theapi/bathroom_scales/datasheets/feather_pinoutbot.jpg

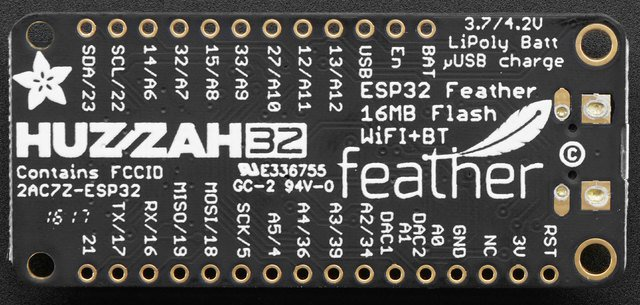
datasheets/feather_pinoutbot.jpg
