theapi/bathroom_scales/README.md

# Bathroom Scales
Hacked bathroom scales to provide data logging

See https://learn.sparkfun.com/tutorials/load-cell-amplifier-hx711-breakout-hookup-guide

Sparkfun repo: https://github.com/sparkfun/HX711-Load-Cell-Amplifier

Library: https://github.com/bogde/HX711
