theapi/bathroom_scales/kicad/stm32L031F4/lcd_reader/project.kicad_pcb

## KiCad design kicad/stm32L031F4/lcd_reader/project.kicad_pcb (2017-12-19)

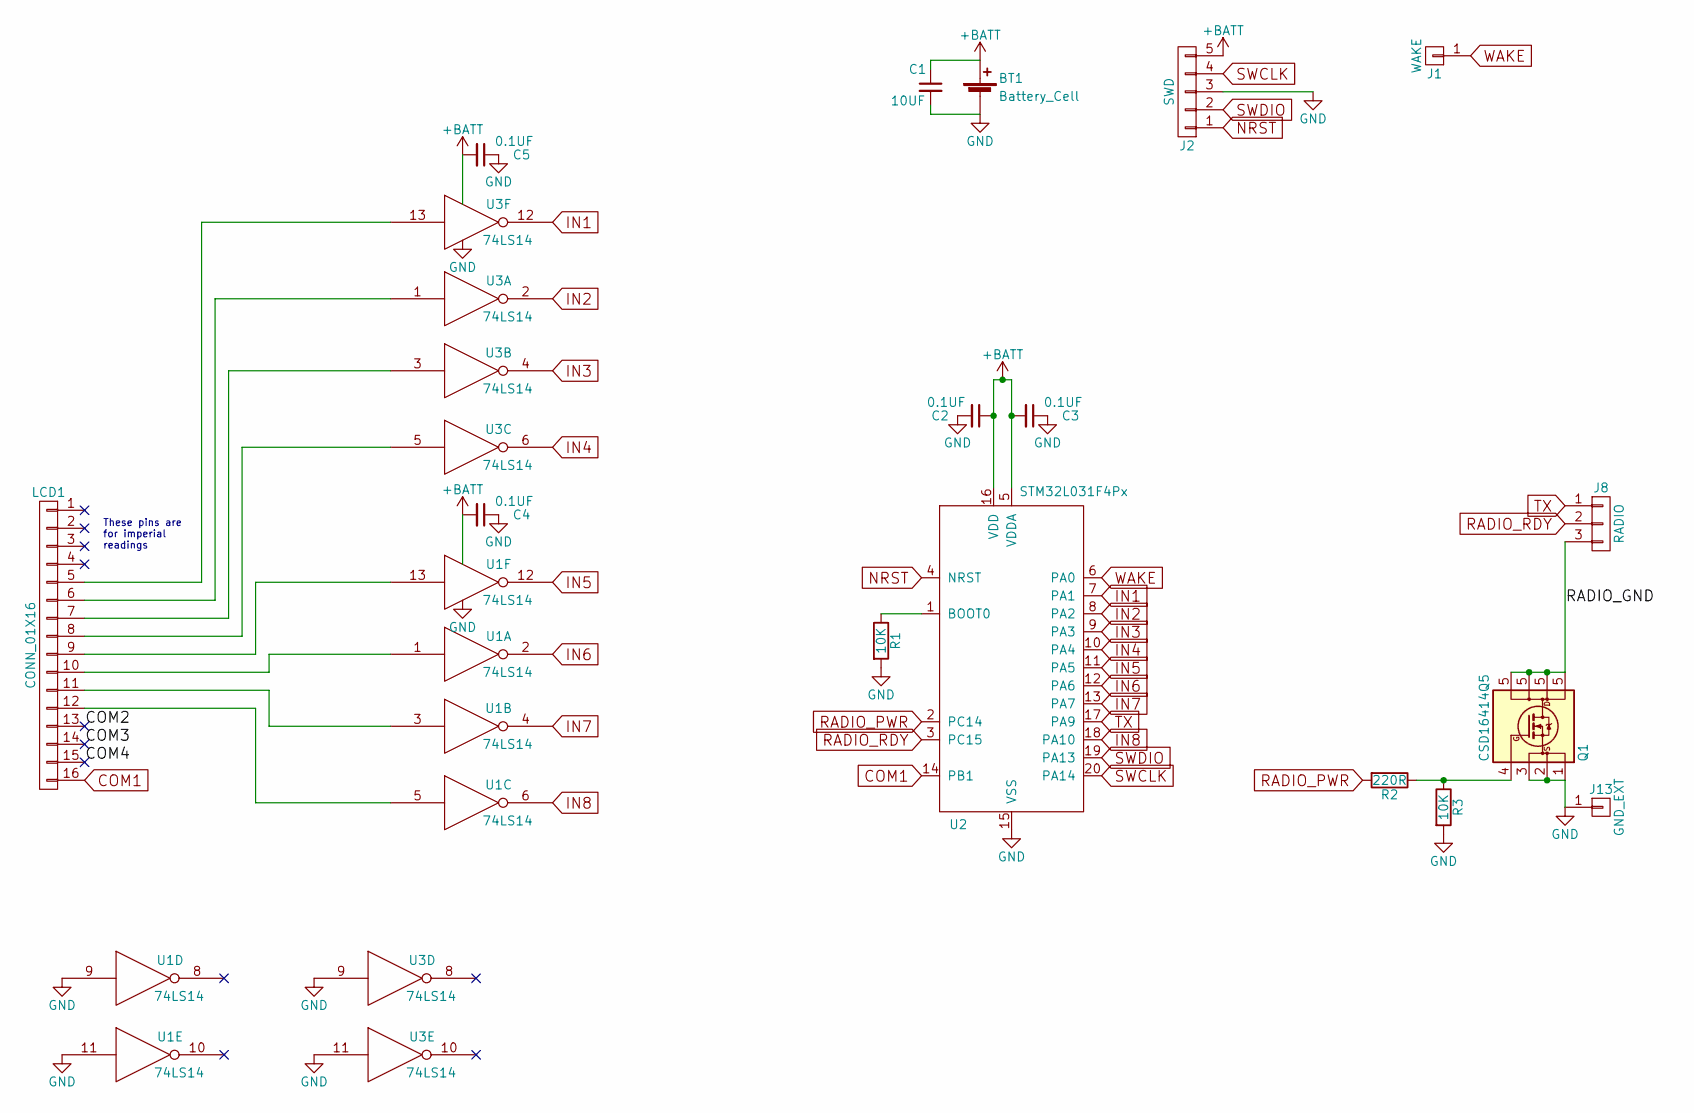
[picture p4: schematic project.sch, LCD Reader]

Parts:
BT1: Battery_Cell; Pin_Header_Straight_2x01_Pitch2.54mm
C1: 10UF; C_0805_HandSoldering
C2, C3, C4, C5: 0.1UF; C_0805_HandSoldering
J1: WAKE; Pin_Header_Straight_1x01_Pitch2.54mm
J2: SWD; Pin_Header_Straight_1x05_Pitch2.54mm
J8: RADIO; Pin_Header_Straight_1x03_Pitch2.54mm
J13: GND_EXT; Pin_Header_Straight_1x01_Pitch2.54mm
LCD1: CONN_01X16; ZEBRA-16
Q1: CSD16414Q5; TDSON-8-1_HandSoldering
R1, R3: 10K; R_0805_HandSoldering
R2: 220R; R_0805_HandSoldering
U1, U3: 74LS14; SOIC-14_3.9x8.7mm_Pitch1.27mm
U2: STM32L031F4Px; TSSOP-20_4.4x6.5mm_Pitch0.65mm

Connections:
+BATT: BT1.1 (+), C1.1, C2.1, C3.2, C4.2, C5.2, J2.5, U1.14 (VCC), U2.5 (VDDA), U2.16 (VDD), U3.14 (VCC)
/COM2: LCD1.13
/COM3: LCD1.14
/COM4: LCD1.15
/RADIO_GND: J8.3, Q1.5 (D)
COM1: LCD1.16, U2.14 (PB1)
GND: BT1.2 (-), C1.2, C2.2, C3.1, C4.1, C5.1, J2.3, J13.1, Q1.1 (S), Q1.2 (S), Q1.3 (S), R1.2, R3.2, U1.7 (GND), U1.9, U1.11, U2.15 (VSS), U3.7 (GND), U3.9, U3.11
IN1: U2.7 (PA1), U3.12
IN2: U2.8 (PA2), U3.2
IN3: U2.9 (PA3), U3.4
IN4: U2.10 (PA4), U3.6
IN5: U1.12, U2.11 (PA5)
IN6: U1.2, U2.12 (PA6)
IN7: U1.4, U2.13 (PA7)
IN8: U1.6, U2.18 (PA10)
NRST: J2.1, U2.4 (NRST)
unnamed: LCD1.5, U3.13
unnamed: LCD1.6, U3.1
unnamed: LCD1.7, U3.3
unnamed: LCD1.8, U3.5
unnamed: LCD1.9, U1.13
unnamed: LCD1.10, U1.1
unnamed: LCD1.11, U1.3
unnamed: LCD1.12, U1.5
unnamed: Q1.4 (G), R2.1, R3.1
unnamed: R1.1, U2.1 (BOOT0)
RADIO_PWR: R2.2, U2.2 (PC14)
RADIO_RDY: J8.2, U2.3 (PC15)
SWCLK: J2.4, U2.20 (PA14)
SWDIO: J2.2, U2.19 (PA13)
TX: J8.1, U2.17 (PA9)
WAKE: J1.1, U2.6 (PA0)

Notes on the sheet:
These pins are for imperial readings

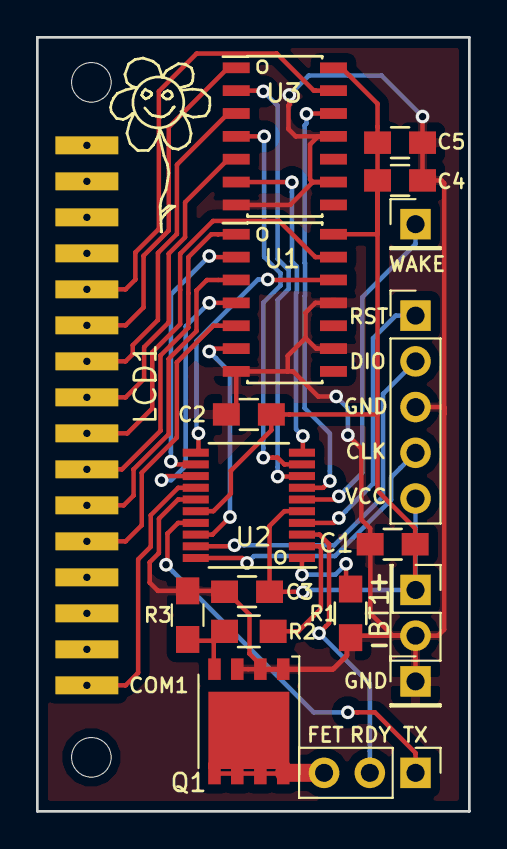
[picture p5: board project.kicad_pcb from above]

Board: 2 copper layers, 24.0 x 43.0 mm, 18 parts (0 on the bottom side), 29 nets.
