theapi/bathroom_scales/stm32L031F4/scales_lcd_read/scales_lcd_read/Src/main.c

/**
  ******************************************************************************
  * File Name          : main.c
  * Description        : Main program body
  ******************************************************************************
  ** This notice applies to any and all portions of this file
  * that are not between comment pairs USER CODE BEGIN and
  * USER CODE END. Other portions of this file, whether 
  * inserted by the user or by software development tools
  * are owned by their respective copyright owners.
  *
  * COPYRIGHT(c) 2017 STMicroelectronics
  *
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
  ******************************************************************************
  */

/* Includes ------------------------------------------------------------------*/
#include "main.h"
#include "stm32l0xx_hal.h"
#include "adc.h"
#include "usart.h"
#include "gpio.h"

/* USER CODE BEGIN Includes */
#include "string.h"
#include "stdlib.h"

#include "lcd.h"
#include "tx.h"
#include "scales.h"

/* USER CODE END Includes */


/* USER CODE BEGIN PV */

/* USER CODE END PV */

void SystemClock_Config(void);

/* USER CODE BEGIN PFP */
void standby();

/* USER CODE END PFP */

/* USER CODE BEGIN 0 */


TXState_TypeDef tx_state = TXSTATE_OFF;

LCD_TypeDef lcd;

/* USER CODE END 0 */

int main(void)
{

  /* MCU Configuration----------------------------------------------------------*/

  /* Reset of all peripherals, Initializes the Flash interface and the Systick. */
  HAL_Init();

  /* Configure the system clock */
  SystemClock_Config();

  /* Initialize all configured peripherals */
  MX_GPIO_Init();
  MX_ADC_Init();
  MX_USART2_UART_Init();

  /* USER CODE BEGIN 2 */

  /* Disable the uart for now */
  HAL_UART_MspDeInit(&huart2);

  /* Check if the system was resumed from Standby mode */
  if (__HAL_PWR_GET_FLAG(PWR_FLAG_SB) != RESET) {
    /* Clear Standby flag */
    __HAL_PWR_CLEAR_FLAG(PWR_FLAG_SB);
  }

  /* Enable Ultra low power mode */
  HAL_PWREx_EnableUltraLowPower();
  //HAL_PWR_EnableWakeUpPin(PWR_WAKEUP_PIN1);

  /* Ensure the transmitter is off */
  HAL_GPIO_WritePin(GPIOC, GPIO_PIN_14, GPIO_PIN_RESET);

  HAL_ADCEx_Calibration_Start(&hadc, ADC_SINGLE_ENDED);
  HAL_ADC_Start(&hadc);

  LCD_int(&lcd);

  /* USER CODE END 2 */

  /* Infinite loop */
  /* USER CODE BEGIN WHILE */
  while (1)
  {
  /* USER CODE END WHILE */

  /* USER CODE BEGIN 3 */

      /* Wait for a weight */
      if (tx_state == TXSTATE_OFF) {
          if (LCD_pollForWeight(&lcd) == 1) {
              tx_state = TXSTATE_SETUP;
          }
      }

      /* Send the weight reading to the transmitter */
      tx_state = TX_StateMachineRun(tx_state, &huart2, &lcd);

      /* Nothing left to do, just power down */
      if (tx_state == TXSTATE_COMPLETE) {
          /* After standby, setup (main) is run again */
          standby();
      }

  }
  /* USER CODE END 3 */

}

/** System Clock Configuration
*/
void SystemClock_Config(void)
{

  RCC_OscInitTypeDef RCC_OscInitStruct;
  RCC_ClkInitTypeDef RCC_ClkInitStruct;
  RCC_PeriphCLKInitTypeDef PeriphClkInit;

    /**Configure the main internal regulator output voltage 
    */
  __HAL_PWR_VOLTAGESCALING_CONFIG(PWR_REGULATOR_VOLTAGE_SCALE3);

    /**Initializes the CPU, AHB and APB busses clocks 
    */
  RCC_OscInitStruct.OscillatorType = RCC_OSCILLATORTYPE_MSI;
  RCC_OscInitStruct.MSIState = RCC_MSI_ON;
  RCC_OscInitStruct.MSICalibrationValue = 0;
  RCC_OscInitStruct.MSIClockRange = RCC_MSIRANGE_4;
  RCC_OscInitStruct.PLL.PLLState = RCC_PLL_NONE;
  if (HAL_RCC_OscConfig(&RCC_OscInitStruct) != HAL_OK)
  {
    _Error_Handler(__FILE__, __LINE__);
  }

    /**Initializes the CPU, AHB and APB busses clocks 
    */
  RCC_ClkInitStruct.ClockType = RCC_CLOCKTYPE_HCLK|RCC_CLOCKTYPE_SYSCLK
                              |RCC_CLOCKTYPE_PCLK1|RCC_CLOCKTYPE_PCLK2;
  RCC_ClkInitStruct.SYSCLKSource = RCC_SYSCLKSOURCE_MSI;
  RCC_ClkInitStruct.AHBCLKDivider = RCC_SYSCLK_DIV1;
  RCC_ClkInitStruct.APB1CLKDivider = RCC_HCLK_DIV1;
  RCC_ClkInitStruct.APB2CLKDivider = RCC_HCLK_DIV1;

  if (HAL_RCC_ClockConfig(&RCC_ClkInitStruct, FLASH_LATENCY_0) != HAL_OK)
  {
    _Error_Handler(__FILE__, __LINE__);
  }

  PeriphClkInit.PeriphClockSelection = RCC_PERIPHCLK_USART2;
  PeriphClkInit.Usart2ClockSelection = RCC_USART2CLKSOURCE_SYSCLK;
  if (HAL_RCCEx_PeriphCLKConfig(&PeriphClkInit) != HAL_OK)
  {
    _Error_Handler(__FILE__, __LINE__);
  }

    /**Configure the Systick interrupt time 
    */
  HAL_SYSTICK_Config(HAL_RCC_GetHCLKFreq()/1000);

    /**Configure the Systick 
    */
  HAL_SYSTICK_CLKSourceConfig(SYSTICK_CLKSOURCE_HCLK);

  /* SysTick_IRQn interrupt configuration */
  HAL_NVIC_SetPriority(SysTick_IRQn, 0, 0);
}

/* USER CODE BEGIN 4 */

void standby() {
  /* The Following Wakeup sequence is highly recommended prior to each Standby mode entry
    mainly when using more than one wakeup source this is to not miss any wakeup event.
     - Disable all used wakeup sources,
     - Clear all related wakeup flags,
     - Re-enable all used wakeup sources,
     - Enter the Standby mode.
  */

  /* Disable all used wakeup sources: PWR_WAKEUP_PIN3 */
  HAL_PWR_DisableWakeUpPin(PWR_WAKEUP_PIN1);

  /* Clear all related wakeup flags*/
  __HAL_PWR_CLEAR_FLAG(PWR_FLAG_WU);

  /* Enable WakeUp Pin PWR_WAKEUP_PIN3 connected to PA.02 (Arduino A7) */
  HAL_PWR_EnableWakeUpPin(PWR_WAKEUP_PIN1);

  /* Enter the Standby mode */
  HAL_PWR_EnterSTANDBYMode();

}

/**
 * Callback for HAL_GPIO_EXTI_IRQHandler()
 * in EXTI0_1_IRQHandler().
 *
 * Handles the external interrupt.
 */
void HAL_GPIO_EXTI_Callback(uint16_t GPIO_Pin) {
    //@todo
}

/* USER CODE END 4 */
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
