theapi/bathroom_scales/stm32L031F4/scales_lcd_read/scales_lcd_read/scales_lcd_read.ioc

Mcu.UserName=STM32L031F4Px
PA0-CK_IN.Signal=SYS_WKUP1
PA1.Signal=GPIO_Input
PA10.Signal=GPIO_Input
PA13.Signal=SYS_SWDIO
PA14.Signal=SYS_SWCLK
PA2.Signal=GPIO_Input
PA3.Signal=GPIO_Input
PA4.Signal=GPIO_Input
PA5.Signal=GPIO_Input
PA6.Signal=GPIO_Input
PA7.Signal=GPIO_Input
PA9.Signal=USART2_TX
PB1.Signal=ADC_IN9
PC14-OSC32_IN.Signal=GPIO_Output
PC15-OSC32_OUT.Signal=GPIO_Input
