theapi/bathroom_scales/(commit log)

2017-10-05 Start of schematic
    [scales.kicad_pcb, scales.sch]
2017-10-05 Wake up is simply rising edge
    [scales.sch]
2017-10-06 ESP32 WROOM
    [ESP32-Footprints.kicad_pcb, ESP32-Footprints.sch, scales.sch]
2017-10-07 Battery voltage
2017-10-09 Send battery reading
2017-10-10 Changed battery pin to one that supports ADC1
2017-10-11 Esp32 specific
    [ESP32-Footprints.kicad_pcb, ESP32-Footprints.sch, scales.kicad_pcb, scales.sch]
2017-10-22 HX711 expriments with arduino nano
2017-10-28 Use pin 34 (A2 on Adafruit feather) for wake up
2017-10-28 Check pin 34 status
2017-10-29 Use COM0 as the start frame indicator
2017-10-29 Only serial print the reading
2017-10-29 Schmitt trigger & ESP32 Feather pinout
2017-11-04 Fails to read due to wifi hogginf resources
    [bathroom_scales.ino]
2017-11-04 Start of reading the lcd with an stm32L031F4
2017-11-04 Slower programming
    [scales_lcd_read Debug.cfg]
2017-11-05 Disable the uart after transmission
    [scales_lcd_read Debug.cfg]
2017-11-05 HAL reconfigures the pin input
2017-11-05 Lower power voltage scale
2017-11-05 Start of esp32 just for thewifi
2017-11-06 stm32L031F4 board
    [project.kicad_pcb, project.sch]
2017-11-06 All connected
    [project.kicad_pcb]
2017-11-07 Silkscreen tidying
    [project.kicad_pcb, project.sch]
2017-11-08 Start of zebra strip compatability
    [project.kicad_pcb, project.sch]
2017-11-08 Layout for sandwiched zebra connector
    [project-B.Cu.gbl, project-B.Mask.gbs, project-B.SilkS.gbo, project-Edge.Cuts.gm1, project-F.Cu.gtl, project-F.Mask.gts, project-F.SilkS.gto, project-NPTH.drl]
2017-11-09 Main zebra connection on the top
    [project-B.Cu.gbl, project-B.Mask.gbs, project-B.SilkS.gbo, project-Edge.Cuts.gm1, project-F.Cu.gtl, project-F.Mask.gts, project-F.SilkS.gto, project-NPTH.drl]
2017-11-09 SOIC-14 for the schmitt triggers
    [project-B.Cu.gbl, project-B.Mask.gbs, project-B.SilkS.gbo, project-Edge.Cuts.gm1, project-F.Cu.gtl, project-F.Mask.gts, project-F.SilkS.gto, project-NPTH.drl]
2017-11-20 Send the weight to the esp32
2017-11-21 Communication between esp32 & STM32
2017-11-21 Crude power control of the transmitter
2017-11-22 Sleep with no wake until power cycle
2017-12-19 Pull down on mosfet gate
    [project.kicad_pcb, project.sch]
