theapi/bathroom_scales/(notices)

Notices in the files:
stm32L031F4/scales_lcd_read/scales_lcd_read/Src/main.c:
(C) COPYRIGHT STMicroelectronics *****END OF FILE
